EliasSchiel/AirWard-Version-0.5/hardware/README.md

# Hardware

Piezas para impresión 3D (PLA) y etiquetas de los nodos.

- `Tapa_pantalla_A_pendiente.stl` y `Tapa_pantalla_B_franja.stl`: tapa trasera de la pantalla, en dos piezas que se imprimen sin soportes.
- `Etiquetas_AirWard.pdf`: etiquetas con logo para los tres nodos.

Agregá acá el resto de los STL (cajas del nodo MQ-7, del nodo CO₂ y de la pantalla).
