EliasSchiel/AirWard-Version-0.5/docs/AirWard_presentacion_final.pptx

## AirWard

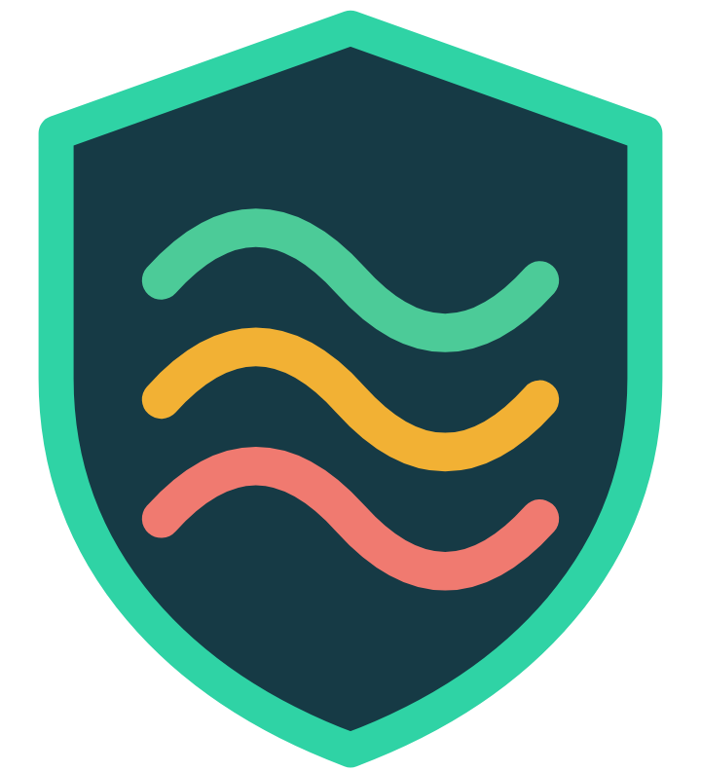
[picture p9: figure]
Logo de AirWard: un escudo con tres ondas de aire en colores de semáforo

MONITOR DE CALIDAD DEL AIRE

El aire que respirás, a la vista.

Una red de sensores que mide el aire de una sala y te lo muestra en tiempo real.

Notes: Bienvenida. AirWard es un equipo de sensores que mide el aire de un ambiente cerrado y lo muestra en una pantalla y en una web, en vivo. Si hay tiempo, mostrar la pantalla funcionando mientras se habla.

## ¿Cuánto CO₂ hay en esta sala ahora mismo?

Probablemente no lo sabés: no se ve, no se huele y, aun así, nos afecta.

AirWard

Notes: Arrancar con la pregunta al público. Dejar un segundo de silencio y después contar que justamente de eso trata AirWard: hacer visible algo que no se ve.

## Tres cosas del aire que no se ven

CO₂

DIÓXIDO DE CARBONO

Sube cuando hay mucha gente y poca ventilación. Da sueño, dolor de cabeza y cuesta concentrarse.

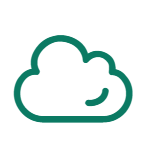
[picture p10: figure]
Cloud

CO

MONÓXIDO DE CARBONO

Lo producen estufas y calefones mal ventilados. No tiene olor ni color, y puede ser muy peligroso.

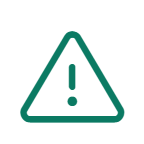
[picture p11: figure]
Warning

Ambiente

TEMPERATURA Y HUMEDAD

Un lugar muy seco, frío o caluroso también cansa. Medirlo ayuda a estar cómodo.

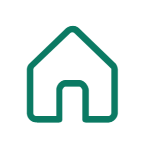
[picture p12: figure]
Home

AirWard

Notes: Pasamos la mayor parte del día en interiores y casi nunca sabemos cómo está el aire. Estas son las tres cosas que medimos: el CO₂ (por falta de ventilación), el monóxido de carbono (por combustión) y el ambiente (temperatura y humedad).

## AirWard: tres nodos y una web

NODO 1

CO₂

Un sensor infrarrojo mide cuánto CO₂ hay en el aire.

NODO 2

Monóxido

Un sensor MQ-7 detecta la presencia de monóxido de carbono.

NODO 3

Principal

Mide temperatura y humedad, recibe todo y lo muestra en su pantalla.

Y ADEMÁS

Web en vivo

Desde cualquier celular o PC de la red ves todo al instante.

AirWard

Notes: Esta es la solución: tres cajitas con ESP32, cada una con su sensor, que se comunican por WiFi. Una de ellas tiene pantalla. Además hay una página web que muestra todo desde cualquier celular o computadora de la misma red.

## Cómo viaja un dato

PASO 1

El sensor mide

Cada nodo lee el aire y arma un mensaje chiquito.

PASO 2

Viaja por WiFi

El mensaje sale con un protocolo liviano llamado MQTT.

PASO 3

Llega al broker

Un servidor recibe todo y lo envía a las presentaciones

PASO 4

Lo ves

La pantalla y la web lo muestran al instante.

Todo pasa dentro de la misma red local: no hace falta internet ni la nube.

AirWard

Notes: Explicar con palabras simples: el sensor mide, el nodo manda un mensaje por WiFi, una computadora lo recibe y lo reparte, y la pantalla y la web lo muestran. MQTT es el idioma liviano que usan los dispositivos para hablar entre sí. Los datos se quedan en la red local.

## Qué podés ver y probar acá

La pantalla

Cambia sola cada 10 segundos: resumen con barras, detalle de CO₂, de CO y del ambiente.

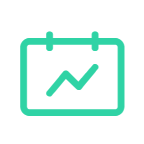
[picture p13: figure]
Activity

La web en vivo

Tarjetas por sensor, gráficos de los últimos 5 minutos y un mapa 3D donde ves viajar cada mensaje.

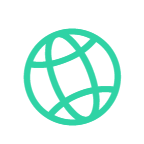
[picture p14: figure]
Globe

Probá esto

Respirá cerca del sensor de CO₂ y mirá cómo sube el número en la pantalla.

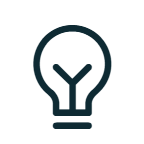
[picture p15: figure]
Lightbulb

AirWard

Notes: Invitar al público a mirar la pantalla y la web en el stand. La prueba de respirar cerca del sensor de CO₂ funciona muy bien: el número sube en pocos segundos y después vuelve a bajar.

## El semáforo del aire

Así se lee el CO₂ en la pantalla y en la web.

Buena

menos de 800 ppm

Aire fresco. Todo bien.

Regular

800 a 1200 ppm

Conviene ventilar pronto.

Mala

más de 1200 ppm

Abrí las ventanas ahora.

ppm = partes por millón: cuántas moléculas de CO₂ hay por cada millón de moléculas de aire.

AirWard

Notes: El aire exterior ronda las 420 ppm de CO₂. Hasta 800 ppm se considera buena calidad; entre 800 y 1200 conviene ventilar; por encima de 1200 el ambiente está cargado. Estos son los umbrales que usan la pantalla y la web de AirWard.

## Cómo lo construimos

1

Sensores y soldadura

Armamos y probamos cada nodo por separado.

2

Mensajes por WiFi

Cada nodo publica sus datos con MQTT.

3

Broker con Docker

Un solo comando levanta el servidor y la web.

4

Pantalla y web

Paneles que rotan, gráficos y un mapa 3D de la red.

5

Cajas impresas en 3D

A medida de cada placa, con ventilación para el sensor.

6

Prueba y error

Un sensor que no respondía y cajas rediseñadas: así se aprende.

AirWard

Notes: Contar el proceso en pocas palabras. Se puede mencionar alguna anécdota: el sensor de temperatura que no respondía, la pantalla que se apagaba al mover los cables, las cajas que hubo que rediseñar porque las medidas no coincidían.

## Para quién puede ser útil

Aulas

Ventilar a tiempo ayuda a que todos sigan atentos.

Casas en invierno

Ayuda a notar a tiempo un aire cargado por estufas y calefones.

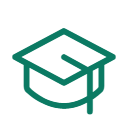
[picture p16: figure]
GraduationCap
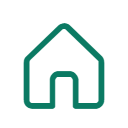
[picture p17: figure]
Home

Oficinas y locales

Ventilar solo cuando hace falta, sin gastar de más en calefacción.

Escuelas y talleres

Un proyecto real para aprender electrónica, redes y datos.

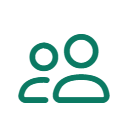
[picture p18: figure]
Users
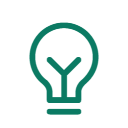
[picture p19: figure]
Lightbulb

AirWard

Notes: Pensar en quién tiene enfrente: una persona que quiere saber para qué sirve. Aulas, casas con estufa en invierno, oficinas y locales, y escuelas como herramienta para enseñar. Aclarar que no reemplaza a un detector de monóxido homologado.

## Gracias por pasar

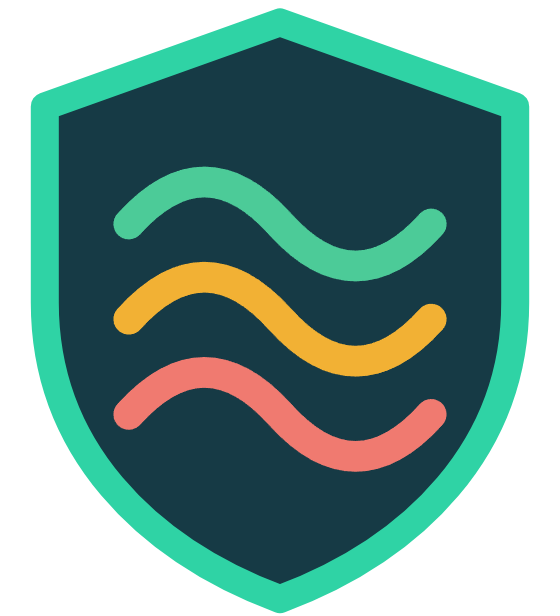
[picture p20: figure]
Logo de AirWard: un escudo con tres ondas de aire en colores de semáforo

Preguntanos lo que quieras, estamos acá.

¿Lo querés para tu casa, tu aula o tu oficina? Hablemos.

Notes: Cierre. Agradecer, invitar a probar el sensor y a preguntar. Si alguien muestra interés en tener uno, mencionar que se puede armar como kit o instalar en escuelas y oficinas.
