EliasSchiel/AirWard-Version-0.5/hardware/Etiquetas_AirWard.pdf

### Etiquetas AirWard

Imprimir al 100% (tamaño real, sin "ajustar a la página") en papel adhesivo. Cada etiqueta mide 64 x 36 mm. Hay 2 de cada una.

AIRWARD
CO

Monóxido de carbono
Sensor MQ-7

AIRWARD
CO

Monóxido de carbono
Sensor MQ-7

AIRWARD

# CO₂

Dióxido de carbono
Sensor MH-Z19

AIRWARD

# CO₂

Dióxido de carbono
Sensor MH-Z19

AIRWARD
°C · %

Nodo principal
Temperatura y humedad
Con pantalla

AIRWARD
°C · %

Nodo principal
Temperatura y humedad
Con pantalla
