EliasSchiel/AirWard-Version-0.5/hardware/Tapa_pantalla_A_pendiente.stl

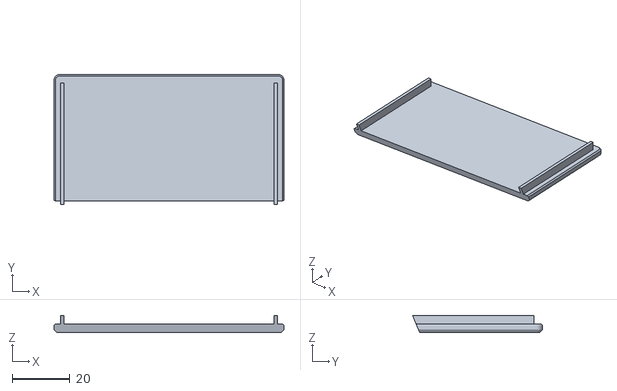
[picture p21: CAD file, 2026-10-28]
hardware/Tapa_pantalla_A_pendiente.stl
80.0 x 45.2 x 6.00
