EliasSchiel/AirWard-Version-0.5/hardware/Tapa_pantalla_B_franja.stl

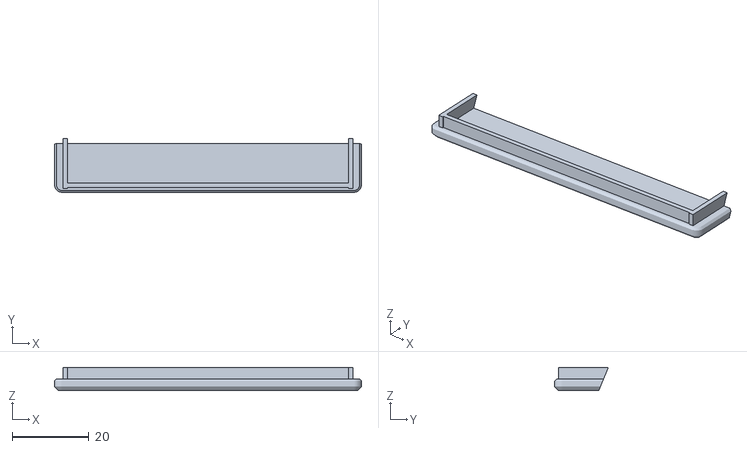
[picture p22: CAD file, 2026-10-28]
hardware/Tapa_pantalla_B_franja.stl
80.0 x 14.0 x 6.00
