EliasSchiel/AirWard-Version-0.5/(commit log)

2026-10-28 AirWard v0.5: nodos ESP32, MQTT en Docker, web y carcasas
    [Tapa_pantalla_A_pendiente.stl, Tapa_pantalla_B_franja.stl]
2026-11-11 Pantalla: CO2 y CO se redibujan solo cuando cambia el valor
2026-11-11 Actualizacion con actividad de microcontroladores 2
2026-11-11 Pantalla CO2/CO: ajustes de estilo según requerimientos
2026-11-13 Correcion: simplifique las fuciones que me tocaban
2026-11-13 Actividad ajustar las actualizaciones de manera mas sencilla
